alexfranke/booknook-light-timer/(list of files, drawings)

Other design files:
hardware/pcb/ProPrj_Book Nook Lamp_2026-02-12.epro
