alexfranke/booknook-light-timer/(commit log)

2026-02-12 updates pins/pin logic for better pcb, adds pcb
    [ProPrj_Book Nook Lamp_2026-02-12.epro]
2026-05-08 Fix CAD link and update power consumption values
    Updated CAD link and corrected power consumption details in the readme.
